LaboratoryStuff/Lebold-Didatic-51660/README.md

Portection cover for Lebold Didatic GMBH Tangential B-probe (51660).
The cover is designed to be 3D printed.
A STEP and a G-Code file are provided.
