LaboratoryStuff/Lebold-Didatic-51660/Lebold_51660_Cover_v04_STEP_file.STEP

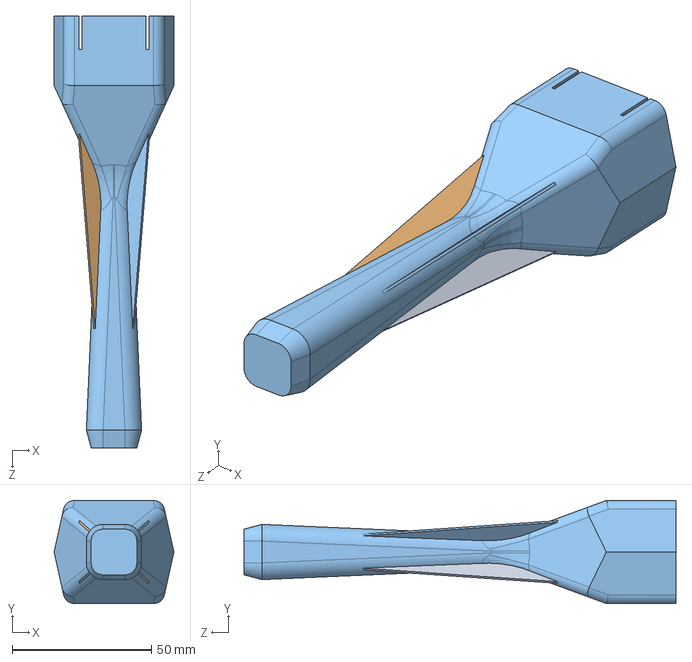
[picture p1: CAD file, 2024-09-26]
Lebold_51660_Cover_v04_STEP_file.STEP
43.0 x 37.0 x 155.0 mm
