LaboratoryStuff/Lebold-Didatic-51660/Lebold_51660_Cover_v04_2D_Drawing.pdf

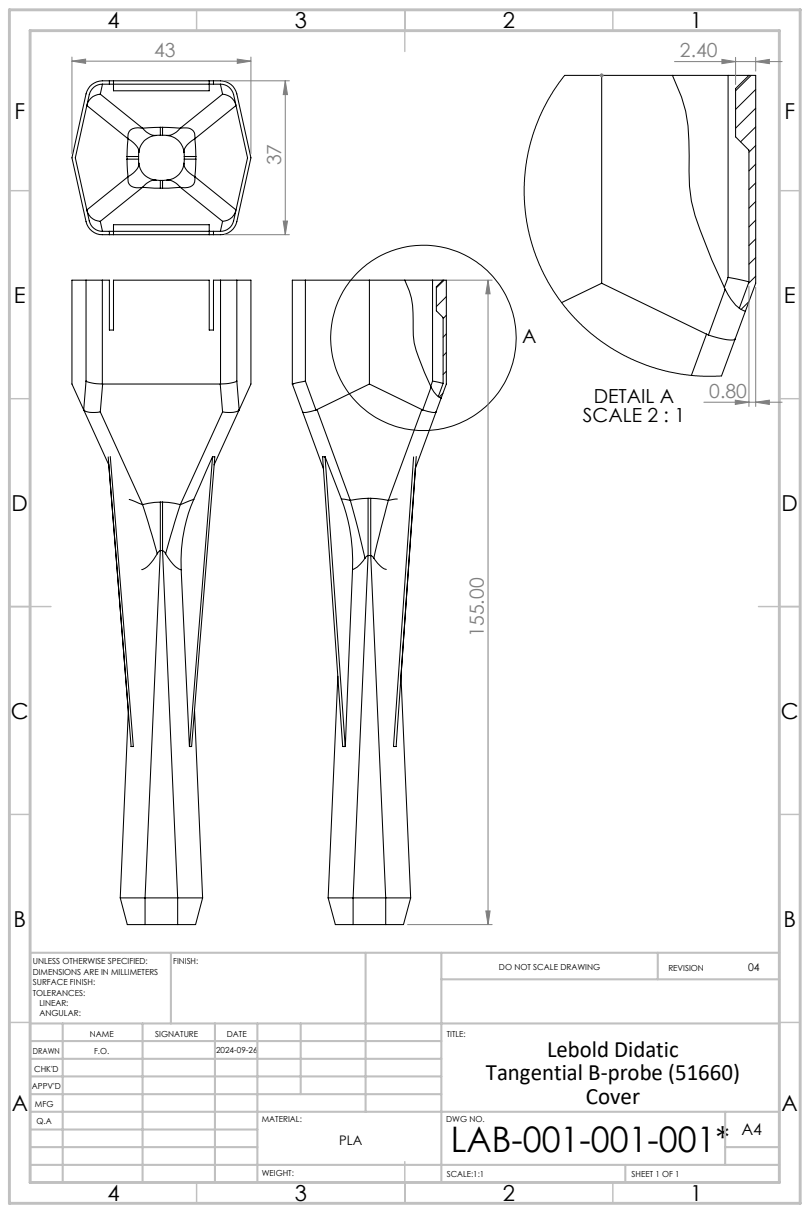
[picture p2: page 1]
DETAIL A; SCALE 2 : 1; DO NOT SCALE DRAWING; REVISION; SCALE:1:1; SHEET 1 OF 1

UNLESS OTHERWISE SPECIFIED:
DIMENSIONS ARE IN MILLIMETERS
SURFACE FINISH:
TOLERANCES:
LINEAR:
ANGULAR:

NAME | SIGNATURE | DATE | | | | TITLE: Lebold Didatic Tangential B-probe (51660) Cover

DRAWN | F.O. | | 2024-09-26
CHK'D
APPV'D
MFG
Q.A | | | | MATERIAL: PLA | DWG NO. LAB-001-001-001* | A4
